pierreblavy2/simon/finished-game-front.jpg

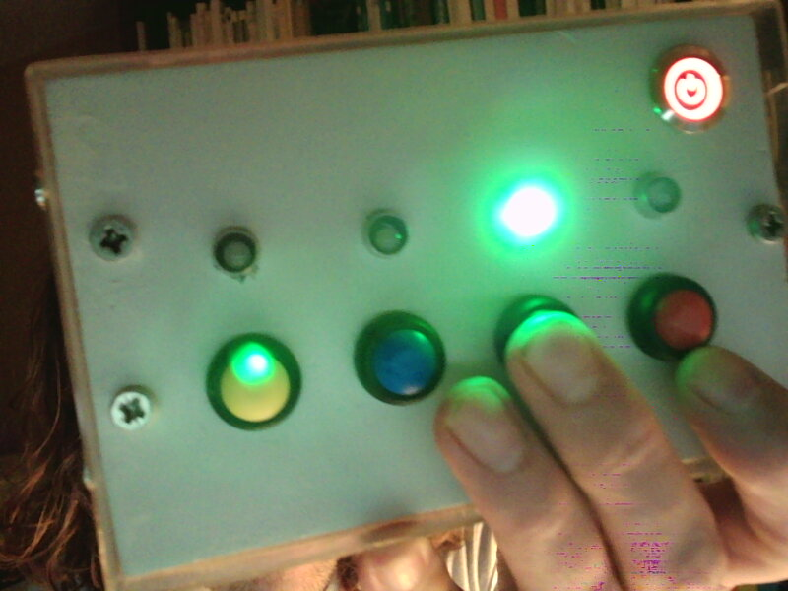
finished-game-front.jpg
