pierreblavy2/simon/finished-game-side.jpg

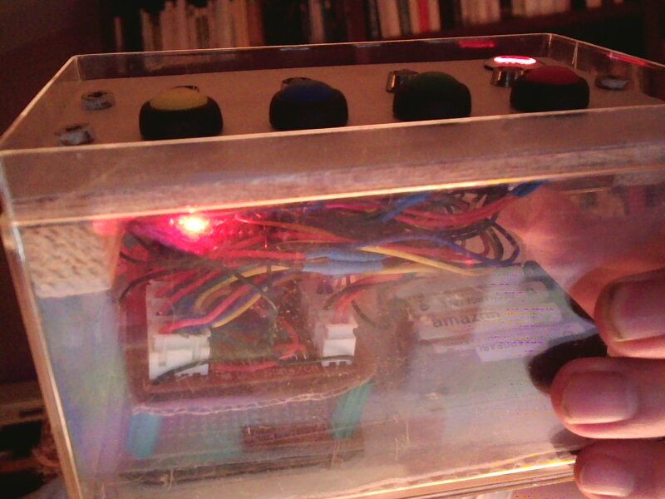
finished-game-side.jpg
